nicoverduin/BP7-BP8-BP9-LiPo-Battery-pack/Electronics/Working pack.jpg

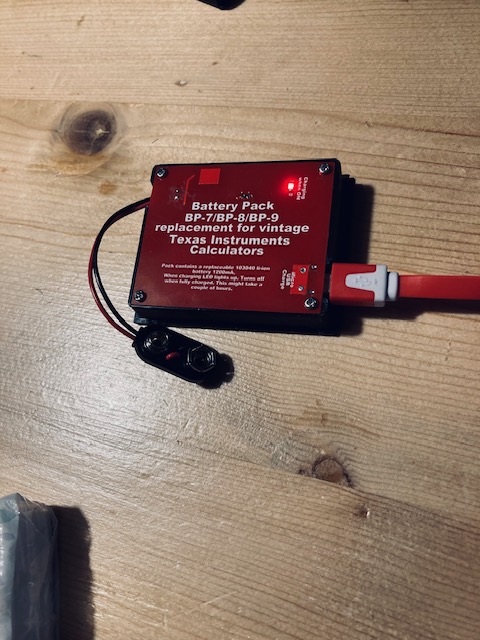
Electronics/Working pack.jpg
