nicoverduin/BP7-BP8-BP9-LiPo-Battery-pack/README.md

# BP7-BP8-BP9-LiPo-Battery-pack-
LiPo battery pack for vintage Texas Instruments Calculators requiring 9V

The inspiration for this project is from this one https://hackaday.io/project/176529-ti-59-lipo-battery-pack

So all credits I suppose should go to tomcircuit
