nicoverduin/BP7-BP8-BP9-LiPo-Battery-pack/Electronics/calculations TPS61041 250mA SMPS 9V.xlsx

Parameter | Value | UOM | Description
Vin | 3.7 | V | Li-ION volatage
Vin(Min) | 3.7 | V | Lowest voltage
Vout | 9 | V | Required output voltage
Imax | 0.250 | A | Max current chip
Iload | 0.100 | A | Nominal load
Iload(Max) | 0.164 | A | Theoretical maximum load current
η | 80% |  | Efficiency factor
L | 33 | uH | Inductor
Vd | 0.375 | V | Voltage drop diode
Propagation delay | 100 | nS | Switching delay mosfet in chip
Ipeak | 0.261 | A | Peak current during switching
Iminimum Saturation | 0.3 | A | Minimul inductor saturation current
fS(max) | 0.967686 | Mhz | Maximum switching frequency
fS(I Load) | 0.504075 | Mhz | Typical switching frequency
Calcuilating R1 and R2
R1 | 1200000 | Ω | <=2.2M
R2 | 190498.2619 | Ω | <=200k
R2 | 191000 | Ω | R2
Vout | 8.98 | V | Vout with a standard resistor
Vout | 9.0 | V
R2calculated | 190498.2619 |  | Choose 100K + 91K = 191K
Calculating Cff and Cin and Cout
Cff | 2.21 | pF | Feed forward capacitor
Cout | 4.7 | uF | 16V
Cin | 4.7 | uF | 16V
∆Vout | 3.134545497 | V
Boost IC | TPS61041
