nicoverduin/BP7-BP8-BP9-LiPo-Battery-pack/Electronics/Battery Pack BP7-BP8-BP9 BOM.xlsx

Bill of Materials
Project Title: | Bill of Materials for BOM Document [Battery Pack BP8.BomDoc]
Project File Name: | Battery Pack BP8.PrjPcb
Assembly Variant: | None
 |  |  |  |  |  |  |  | PCB prijs |  | Bestel prijs
Description | Designator | Manufacture | Manufacture Part Number | Supplier | Supplier Part Number | Supplier Unit Price | Minimum order Qty | Quantity | Subtotal | Order 10 PCB | Subtotal
General Purpose Ceramic Capacitor, 0805, 4.7uF, 10%, X7R, 15%, 16V | C1, C2, C3, C4, C5 | Kyocera AVX | 0805YC475KAT2A | R/S | 247-7895 | €0.1620 | 10 | 5 | €0.810 | 50 | €8.10
LED 0805 | D1 | Wurth Electronics | 150080RS75000 | R/S | 815-4225 | €0.1620 | 50 | 1 | €0.162 | 50 | €8.10
DIODE ZENER 5.1V 500MW SOD123 | D2 | Diodes | BZT52C5V1-7-F | R/S | 738-4951 | €0.0780 | 200 | 1 | €0.078 | 200 | €15.60
DIODE SCHOTTKY 30V 500MA SOD123 | D3 |  | MBR0530 | R/S | 545-3291 | €0.2650 | 25 | 1 | €0.265 | 25 | €6.62
Micro-USB B Receptacle, Right Angle, Bottom Mount, Surface Mount, with Solder Tabs, -30 to 85 degC, 5-Pin USB, RoHS, Tape and Reel | J1 | Molex | 1050170001 | R/S | 848-6764 | €0.8560 | 5 | 1 | €0.856 | 10 | €8.56
Connector Header, PH Series, 2 Position, 2.00mm, Through Hole, Press-Fit, Solder, Natural | J2 | JST | B2BPHKSLFSN | R/S | 820-1422 | €0.1560 | 5 | 1 | €0.156 | 10 | €1.56
Wire Wound Ferrite Inductor for Power Lines 33μH ±20% 1.38Ω 390mA 1210 | L1 | Murata | LQH32PN330MN0L | R/S | 786-6888 | €0.3210 | 10 | 1 | €0.321 | 10 | €3.21
Male Header, Pitch 2 mm, 1 x 2 Position, Height 5.5 mm, -25 to 85 degC, RoHS, Tape and Reel | P1 | JST | S2B-PH-SM4-TB(LF)(SN) | R/S | 688-1353 | €0.5120 | 5 | 1 | €0.512 | 10 | €5.12
1M2 0805 | R1 | Vishay | CRCW08051M20FKEA | R/S | 679-1046 | €0.0560 | 50 | 1 | €0.056 | 50 | €2.80
191K 0805 | R2 | Panasonic | ERA6AEB1913V | R/S | 708-6806 | €0.0440 | 5 | 1 | €0.044 | 10 | €0.44
4K7 0805 | R3 | Panasonic | ERJT06J472V | R/S | 721-6993 | €0.0150 | 5 | 1 | €0.015 | 10 | €0.15
470R 0805 | R4 | Vishay | CRCW0805470RFKEA | R/S | 679-1428 | €0.0120 | 50 | 1 | €0.012 | 50 | €0.60
TESTPOINT | TP1, TP2, TP3, TP4, TP_GND1
Power Supply Support Circuit, Adjustable, 1 Channel, PDSO5 | U1 | Microchip | MCP73831T-2ACI/OT | R/S | 738-6360P | €0.8040 | 5 | 1 | €0.804 | 10 | €8.04
IC IDEAL DIODE | U2 | Maxim | MAX40203AUK+ | R/S | 192-3037 | €0.8150 | 10 | 1 | €0.815 | 10 | €8.15
28 V, 250 mA Switch Boost Converter for LCD and White LED Applications, 1.8 to 6 V, -40 to 85 degC, 5-pin SOT23 (DBV5), Green (RoHS & no Sb/Br) | U3 | Texas instruments | TPS61041DBVR | R/S | 709-4617 | €1.5480 | 5 | 1 | €1.548 | 10 | €15.48
 |  |  |  |  |  |  |  | 19 | €6.45 | 515 | €92.54
 | Notes
 | ● Elke type 0805 weerstand zal het wel doen. De 1.2M (R1) en 191K (R2) zijn kritisch mbt de betrouwbaarheid ivm 9V boost
