nicoverduin/BP7-BP8-BP9-LiPo-Battery-pack/Electronics/Project Outputs for Battery Pack BP8/Battery Pack BP7-BP8-BP9 BOM.xlsx

Sheet: Sheet1
Bill of Materials
Project Title: | Bill of Materials for BOM Document [Battery Pack BP8.BomDoc]
Project File Name: | Battery Pack BP8.PrjPcb
Assembly Variant: | None
 |  |  |  |  |  |  |  | PCB prijs |  | Bestel prijs
Description | Designator | Manufacture | Manufacture Part Number | Supplier | Supplier Part Number | Supplier Unit Price | Minimum order Qty | Quantity | Subtotal | Order 10 PCB | Subtotal
General Purpose Ceramic Capacitor, 0805, 4.7uF, 10%, X7R, 15%, 16V | C1, C2, C3, C5 | Kyocera AVX | 0805YC475KAT2A | R/S | 247-7895 | €0.1620 | 10 | 4 | €0.648 | 50 | €8.10
General Purpose Ceramic Capacitor, 0805, 2.2pF | C4 | Wurth Electronics | 885012007100 | R/S | 263-4050 | €0.1620 | 50 | 1 | €0.071 | 50 | €8.10
LED 0805 | D1 | Wurth Electronics | 150080RS75000 | R/S | 815-4225 | €0.1620 | 50 | 1 | €0.162 | 50 | €8.10
DIODE ZENER 5.1V 500MW SOD123 | D2 | Diodes | BZT52C5V1-7-F | R/S | 738-4951 | €0.0780 | 200 | 1 | €0.078 | 200 | €15.60
DIODE SCHOTTKY 30V 500MA SOD123 | D3 |  | MBR0530 | R/S | 545-3291 | €0.2650 | 25 | 1 | €0.265 | 25 | €6.62
Micro-USB B Receptacle, Right Angle, Bottom Mount, Surface Mount, with Solder Tabs, -30 to 85 degC, 5-Pin USB, RoHS, Tape and Reel | J1 | Molex | 1050170001 | R/S | 848-6764 | €0.8560 | 5 | 1 | €0.856 | 10 | €8.56
Connector Header, PH Series, 2 Position, 2.00mm, Through Hole, Press-Fit, Solder, Natural | J2 | JST | B2BPHKSLFSN | R/S | 820-1422 | €0.1560 | 5 | 1 | €0.156 | 10 | €1.56
Wire Wound Ferrite Inductor for Power Lines 33μH ±20% 1.38Ω 390mA 1210 | L1 | Murata | LQH32PN330MN0L | R/S | 786-6888 | €0.2310 | 10 | 1 | €0.231 | 10 | €2.31
Male Header, Pitch 2 mm, 1 x 2 Position, Height 5.5 mm, -25 to 85 degC, RoHS, Tape and Reel | P1 | JST | S2B-PH-K-S(LF)(SN) | R/S | 820-1494 | €0.1560 | 5 | 1 | €0.156 | 10 | €1.56
1M2 0805 | R1 | Vishay | CRCW08051M20FKEA | R/S | 679-1046 | €0.0560 | 50 | 1 | €0.056 | 50 | €2.80
100K 0805 | R2 | Vishay | CRCW0805100KFKEA | R/S | 679-0803 | €0.0260 | 50 | 1 | €0.026 | 10 | €0.26
91K 0805 | R2 | Vishay | CRCW080591K0FKEA | R/S | 679-1749 | €0.0440 | 5 | 1 | €0.044 | 10 | €0.44
4K7 0805 | R3 | Panasonic | ERJT06J472V | R/S | 721-6993 | €0.0150 | 5 | 1 | €0.015 | 10 | €0.15
470R 0805 | R4 | Vishay | CRCW0805470RFKEA | R/S | 679-1428 | €0.0120 | 50 | 1 | €0.012 | 50 | €0.60
TESTPOINT | TP1, TP2, TP3, TP4, TP_GND1
Power Supply Support Circuit, Adjustable, 1 Channel, PDSO5 | U1 | Microchip | MCP73831T-2ACI/OT | R/S | 738-6360 | €0.8040 | 5 | 1 | €0.804 | 10 | €8.04
IC IDEAL DIODE | U2 | Maxim | MAX40203AUK+ | R/S | 192-3037 | €0.8150 | 10 | 1 | €0.815 | 10 | €8.15
28 V, 250 mA Switch Boost Converter for LCD and White LED Applications, 1.8 to 6 V, -40 to 85 degC, 5-pin SOT23 (DBV5), Green (RoHS & no Sb/Br) | U3 | Texas instruments | TPS61041DBVR | R/S | 709-4617 | €1.5480 | 5 | 1 | €1.548 | 10 | €15.48
 |  |  |  |  |  |  |  | 20 | €5.94 | 575 | €96.44
 | Notes
 | ● Elke type 0805 weerstand zal het wel doen. De 1.2M (R1) en 191K (R2) zijn kritisch mbt de betrouwbaarheid ivm 9V boost

Sheet: Sheet2
RS-stocknummer | Hoeveelheid | Beschrijving: | S.S.M. | HuidigeS.S.M. |  | Totaal
 |  |  |  | Prijs | Ubetaalt
 |  |  | Each (On a Tape of 10) | €0.13 | 0.134 | 1.34
 |  | Murata, 0805 4.7μF MLCC 16V dc, SMD GCM21BR71C475KA73K (https://nl.rs-online.com/web/p/products/2477895/)
 |  | 10 Op voorraad - de volgende werkdag geleverd indien besteld op werkdagen voor 17:30 uur.
 |  |  | Each (In a Pack of 50) | €0.16 | 0.162 | 8.12
 |  | Wurth Elektronik2 V Red LED 2012 (0805) SMD, WL-SMCW 150080RS75000 (https://nl.rs-online.com/web/p/products/8154225/)
 |  | 50 Op voorraad - de volgende werkdag geleverd indien besteld op werkdagen voor 17:30 uur.
 |  |  | Each (In a Pack of 200) | €0.08 | 0.078 | 15.50
 |  | Diodes Inc, 5.1V Zener Diode 6% 500 mW SMT 2-Pin SOD-123 (https://nl.rs-online.com/web/p/products/7384951/)
 |  | 200 Op voorraad - de volgende werkdag geleverd indien besteld op werkdagen voor 17:30 uur.
 |  |  | Each (In a Pack of 25) | 0.265 | 0.265 | 6.62
 |  | onsemi 30V 500mA, Schottky Diode, 2-Pin SOD-123 MBR0530G (https://nl.rs-online.com/web/p/products/5453291/)
 |  | 25 Op voorraad - de volgende werkdag geleverd indien besteld op werkdagen voor 17:30 uur.
 |  |  | Each (In a Pack of 5) | 0.856 | 0.856 | 4.28
 |  | Molex Right Angle, SMT, Socket Type Micro B 2.0 USB Connector (https://nl.rs-online.com/web/p/products/8486764/)
 |  | 5 Op voorraad - de volgende werkdag geleverd indien besteld op werkdagen voor 17:30 uur.
 |  |  | Each (In a Pack of 5) | 0.156 | 0.156 | 0.78
 |  | JST PH Series Straight Through Hole PCB Header, 2 Contact(s), 2.0mm Pitch, 1 Row(s), Shrouded (https://nl.rs-online.com/web/p/products/8201422/)
 |  | 5 Op voorraad - de volgende werkdag geleverd indien besteld op werkdagen voor 17:30 uur.
 |  |  | Each (In a Bag of 10) | 0.231 | 0.231 | 2.31
 |  | Murata, LQH32PN_N0, 1210 (3225M) Shielded Wire-wound SMD Inductor with a Ferrite Core, 33 μH ±20% Wire-Wound 390mA Idc (https://nl.rs-online.com/web/p/products/7866888/)
 |  | 10 Op voorraad - de volgende werkdag geleverd indien besteld op werkdagen voor 17:30 uur.
 |  |  | Each (In a Pack of 50) | 0.056 | 0.056 | 2.78
 |  | Vishay 1.2MΩ, 0805 (2012M) Thick Film SMD Resistor ±1% 0.125W - CRCW08051M20FKEA (https://nl.rs-online.com/web/p/products/6791046/)
 |  | 50 Op voorraad - de volgende werkdag geleverd indien besteld op werkdagen voor 17:30 uur.
 |  |  | Each (In a Pack of 50) | 0.012 | 0.012 | 0.59
 |  | Vishay 100kΩ, 0805 (2012M) Thick Film SMD Resistor ±1% 0.125W - CRCW0805100KFKEA (https://nl.rs-online.com/web/p/products/6790803/)
 |  | 50 Op voorraad - de volgende werkdag geleverd indien besteld op werkdagen voor 17:30 uur.
 |  |  | Each (In a Pack of 50) | 0.026 | 0.026 | 1.30
 |  | Vishay 91kΩ, 0805 (2012M) Thick Film SMD Resistor ±1% 0.125W - CRCW080591K0FKEA (https://nl.rs-online.com/web/p/products/6791749/)
 |  | 50 Op voorraad - de volgende werkdag geleverd indien besteld op werkdagen voor 17:30 uur.
 |  |  | Each (In a Pack of 5) | 0.156 | 0.156 | 0.78
 |  | JST PH Series Right Angle Through Hole PCB Header, 2 Contact(s), 2.0mm Pitch, 1 Row(s), Shrouded (https://nl.rs-online.com/web/p/products/8201494/)
 |  | 5 Op voorraad - de volgende werkdag geleverd indien besteld op werkdagen voor 17:30 uur.
 |  |  | Each (In a Pack of 5) | 0.012 | 0.012 | 0.06
 |  | Panasonic 4.7kΩ, 0805 (2012M) Thick Film SMD Resistor ±5% 0.25W - ERJT06J472V (https://nl.rs-online.com/web/p/products/7216993/)
 |  | 5 Op voorraad - de volgende werkdag geleverd indien besteld op werkdagen voor 17:30 uur.
 |  |  | Each (In a Pack of 50) | 0.012 | 0.012 | 0.59
 |  | Vishay 470Ω, 0805 (2012M) Thick Film SMD Resistor ±1% 0.125W - CRCW0805470RFKEA (https://nl.rs-online.com/web/p/products/6791428/)
 |  | 50 Op voorraad - de volgende werkdag geleverd indien besteld op werkdagen voor 17:30 uur.
 |  |  | Each (In a Pack of 5) | 0.804 | 0.804 | 4.02
 |  | Microchip MCP73831T-2ACI/OT, Battery Charge Controller IC, 3.75 to 6 V 5-Pin, SOT-23 (https://nl.rs-online.com/web/p/products/7386360/)
 |  | 5 Op voorraad - de volgende werkdag geleverd indien besteld op werkdagen voor 17:30 uur.
 |  |  | Each (In a Pack of 10) | 0.815 | 0.815 | 8.15
 |  | Maxim Integrated MAX40200AUK+T Ideal Diode Controller, 1 Channels, 1A 5 Pin, SOT-23 (https://nl.rs-online.com/web/p/products/1923037/)
 |  | 10 Op voorraad - de volgende werkdag geleverd indien besteld op werkdagen voor 17:30 uur.
 |  |  | Each (In a Pack of 5) | 1.548 | 1.548 | €7.74
 |  | Texas Instruments TPS61041DBVR, Boost Converter, Step Up 250mA Adjustable, 1000 kHz 5-Pin, SOT-23 (https://nl.rs-online.com/web/p/products/7094617/)
 |  | 5 Op voorraad - de volgende werkdag geleverd indien besteld op werkdagen voor 17:30 uur.
