nicoverduin/BP7-BP8-BP9-LiPo-Battery-pack/(list of files, cad)

Other CAD files:
3D print/Base BP8.ipt
