nicoverduin/BP7-BP8-BP9-LiPo-Battery-pack/Electronics/Battery Pack BP8.pdf

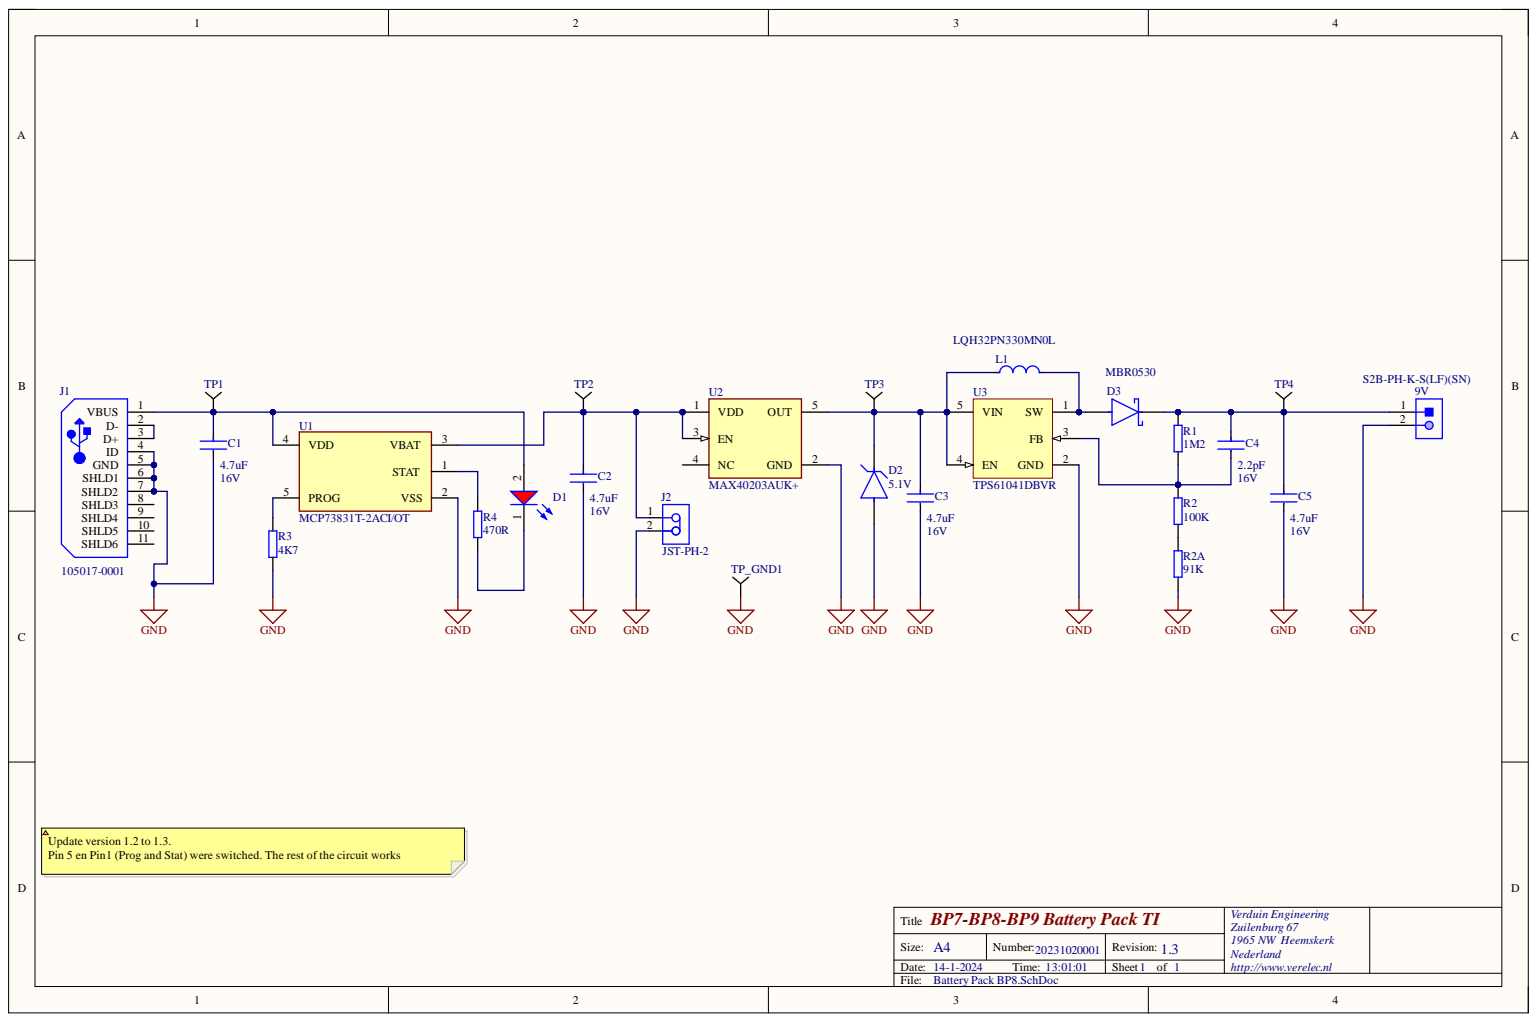
[picture p2: page 1]
