nicoverduin/BP7-BP8-BP9-LiPo-Battery-pack/(list of files, drawings)

Other design files:
Electronics/Battery Pack BP8.PcbDoc
Electronics/Battery Pack BP8.PrjPcb
Electronics/Battery Pack BP8.SchDoc
